H3LLP/Ergo-Split/README.md

# Ergo-Split
Ergonomic Split keyboard
A somewhat low-profile wireless 46-key keyboard that uses a dongle for connection.
Supports Choc V1 and V2 switches, is hotswappable, and uses a 3.7V 800mAh 802535 for each side. PCB is screwed into the case with 2 M2x6 screws and self-taps.

Dongle Case: https://www.printables.com/model/651428-seeed-xiao-ble-case-with-led-hole
(Not made by me)

Firmware is ZMK

AI Disclosure:
Used AI to help with part selection and parts of the firmware




The schematic for the PCB is the same for both sides
