H3LLP/Ergo-Split/BOM.csv

Part | Type | Quantity | Unit price (USD) | Line total (USD) | Link | Vendor | Funding | Notes | Designator | Footprint | Value
0805 SMD Resistor 2M Ohms | Part | 2 | 2.81 | 2.81 | https://www.aliexpress.us/item/3256806797741926.html |  | Grant |  | 2M1, 2M2 | 0805 | R3
0805 SMD Resistor 806K Ohms | Part | 2 | 2.27 | 2.27 | https://www.aliexpress.us/item/3256804997915352.html |  | Grant |  | 806K1, 806K2 | 0805 | R1
1N4148W T4 SOD-123 | Part | 46 | 3.60 | 3.60 | https://www.aliexpress.us/item/3256811977042224.html |  | Grant |  | D1, D10, D11, D12, D13, D14, D15, D16, D17, D18, D19, D2, D20, D21, D22, D23, D24, D25, D26, D27, D28, D29, D3, D30, D31, D32, D33, D34, D35, D36, D37, D38, D39, D4, D40, D41, D42, D43, D44, D45, D... | D_SOD-123 | D
Kalih Choc Low Profile Socket | Part | 46 | 7.37 | 7.37 | https://www.aliexpress.us/item/3256808357010978.html |  | Grant |  | SW1, SW10, SW11, SW12, SW13, SW14, SW15, SW16, SW17, SW18, SW19, SW2, SW20, SW21, SW22, SW23, SW24, SW25, SW26, SW27, SW28, SW29, SW3, SW30, SW31, SW32, SW33, SW34, SW35, SW36, SW37, SW38, SW39, SW... | SW_Hotswap_Kailh_Choc_V1V2_1.00u | ~
XIAO nRF52840 | Part | 3 | 32.08 | 32.08 | https://www.aliexpress.us/item/3256808047100037.html |  | Grant |  | U1, U2 | modified-XIAO-nRF52840-SMD | XIAO-nRF52840-SMD
Any Choc V1/V2 Switches | Part | 46 | 28.23 | 28.23 | https://www.aliexpress.us/item/3256808697103313.html |  | Grant |  | ~ | ~ | ~
3.7V 800mAh 802535 | Part | 2 | 5.99 | 5.99 | https://www.aliexpress.us/item/3256804695633953.html |  | Grant |  | ~ | ~ | ~
Left Case + Right Case | 3D printed | 2 | 17.06 | 17.06 |  |  | Paying myself | JLC3DP | ~ | ~ | ~
keycaps | 3D printed | 46 | 15.04 | 14.72 |  |  | Paying myself | JLC3DP | ~ | ~ | ~
PCB | PCB | 1 | 24.20 | 24.20 |  |  | Grant | JLCPCB | ~ | ~ | ~
M2*6 Screws | Part | 4 | 1.55 | 1.55 | https://www.aliexpress.us/item/2251832624557792.html |  | Already own |  | ~ | ~ | ~
Shipping | Shipping | 1 |  | 29.50 |  |  | Grant
Total |  |  |  | 169.38
Grant total |  |  |  | 136.05
