H3LLP/Ergo-Split/CAD/ErgoKeeb_Right.step

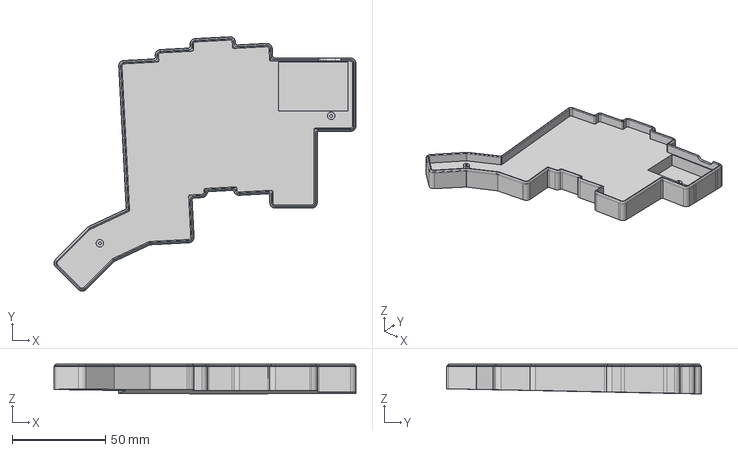
[picture p1: CAD file, 2026-11-11]
CAD/ErgoKeeb_Right.step
161.5 x 136.1 x 16.0 mm
