H3LLP/Ergo-Split/(list of files, cad)

Other CAD files:
CAD/ErgoKeeb_Left.step
CAD/ErgoKeeb.f3z
