H3LLP/Ergo-Split/PCB/ErgoKeeb.kicad_pcb

## KiCad design PCB/ErgoKeeb.kicad_pcb (2026-11-11)

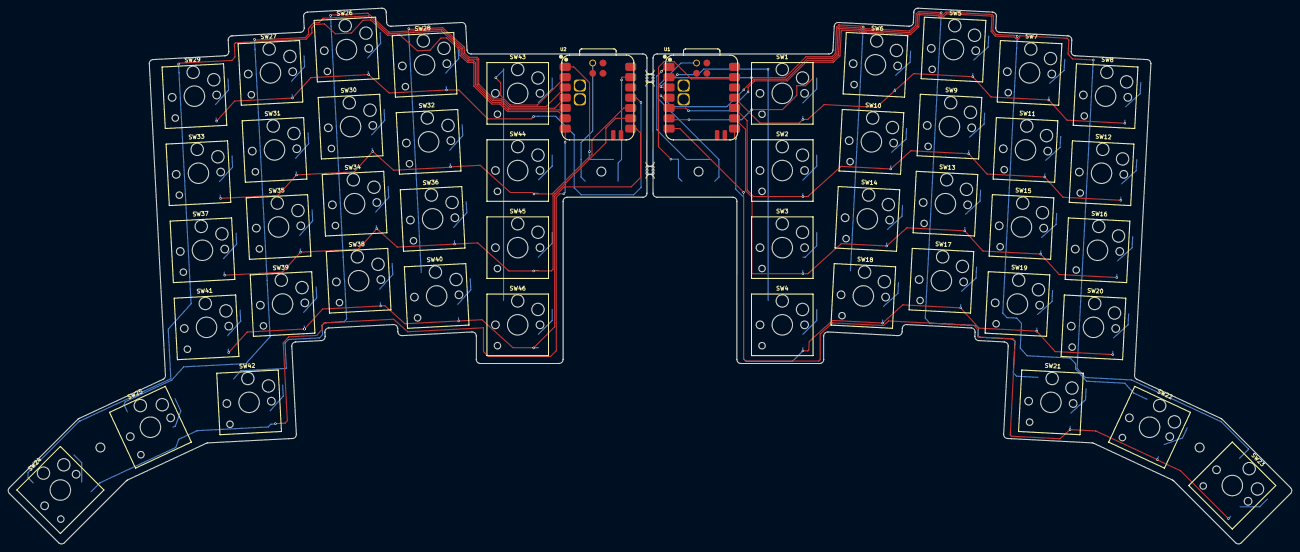
[picture p3: board ErgoKeeb.kicad_pcb from above]

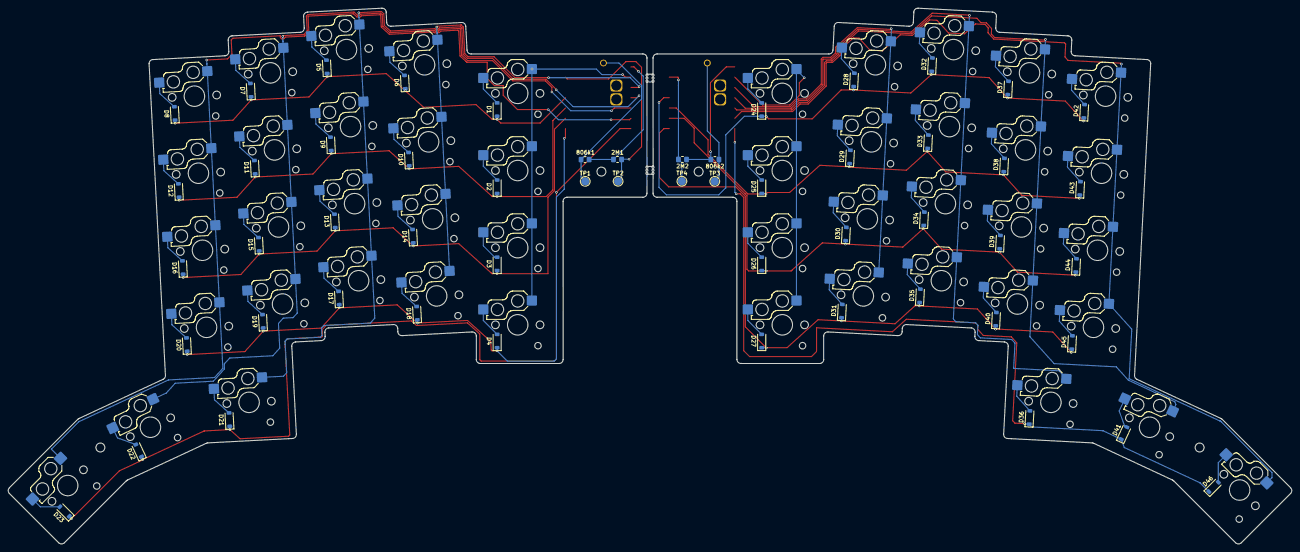
[picture p4: board ErgoKeeb.kicad_pcb from below]

Board: 2 copper layers, 316.9 x 132.3 mm, 108 parts (54 on the bottom side), 72 nets.

Parts:
2M1, 2M2: R3; R_0805_2012Metric_Pad1.20x1.40mm_HandSolder
806k1, 806k2: R1; R_0805_2012Metric_Pad1.20x1.40mm_HandSolder
BO1, BO2: MountingHole; mouse-bite-2mm-slot
D1, D2, D3, D4, D5, D6, D7, D8, D9, D10, D11, D12, D13, D14, D15, D16, D17, D18, D19, D20, D21, D22, D23, D24, D25, D26, D27, D28, D29, D30, D31, D32, D33, D34, D35, D36, D37, D38, D39, D40, D41, D42, D43, D44, D45, D46: D; D_SOD-123
H1, H2, H3, H4: MountingHole; MountingHole_2.2mm_M2
SW1, SW2, SW3, SW4, SW5, SW6, SW7, SW8, SW9, SW10, SW11, SW12, SW13, SW14, SW15, SW16, SW17, SW18, SW19, SW20, SW21, SW22, SW23, SW24, SW25, SW26, SW27, SW28, SW29, SW30, SW31, SW32, SW33, SW34, SW35, SW36, SW37, SW38, SW39, SW40, SW41, SW42, SW43, SW44, SW45, SW46: SW_Hotswap_Kailh_Choc_V1V2_1.00u
TP1, TP3: BAT; TestPoint_Pad_D2.0mm
TP2, TP4: GND; TestPoint_Pad_D2.0mm
U1, U2: XIAO-nRF52840-SMD; modified-XIAO-nRF52840-SMD

Connections:
/left/BT_PIN: 2M1.1, 806k1.2, U1.1 (D0)
/left/Ground: 2M1.2, TP2.1 (1_1), U1.13 (GND)
/left/VBAT: 806k1.1, TP1.1 (1_1), U1.19 (VBAT)
/left/col 0: SW1.1, SW2.1, SW3.1, SW4.1, U1.2 (D1)
/left/col 1: SW6.1, SW10.1, SW14.1, SW18.1, U1.3 (D2)
/left/col 2: SW5.1, SW9.1, SW13.1, SW17.1, SW21.1, U1.4 (D3)
/left/col 3: SW7.1, SW11.1, SW15.1, SW19.1, SW22.1, U1.5 (D4)
/left/col 4: SW8.1, SW12.1, SW16.1, SW20.1, SW23.1, U1.6 (D5)
/left/row 0: D1.1 (K), D5.1 (K), D6.1 (K), D7.1 (K), D8.1 (K), U1.11 (D10)
/left/row 1: D2.1 (K), D9.1 (K), D10.1 (K), D11.1 (K), D12.1 (K), U1.10 (D9)
/left/row 2: D3.1 (K), D13.1 (K), D14.1 (K), D15.1 (K), D16.1 (K), U1.9 (D8)
/left/row 3: D4.1 (K), D17.1 (K), D18.1 (K), D19.1 (K), D20.1 (K), U1.8 (D7)
/left/row 4: D21.1 (K), D22.1 (K), D23.1 (K), U1.7 (D6)
/right/BT_PIN: 2M2.1, 806k2.2, U2.1 (D0)
/right/Ground: 2M2.2, TP4.1 (1_1), U2.13 (GND)
/right/VBAT: 806k2.1, TP3.1 (1_1), U2.19 (VBAT)
/right/col 0: SW43.1, SW44.1, SW45.1, SW46.1, U2.2 (D1)
/right/col 1: SW28.1, SW32.1, SW36.1, SW40.1, U2.3 (D2)
/right/col 2: SW26.1, SW30.1, SW34.1, SW38.1, SW42.1, U2.4 (D3)
/right/col 3: SW25.1, SW27.1, SW31.1, SW35.1, SW39.1, U2.5 (D4)
/right/col 4: SW24.1, SW29.1, SW33.1, SW37.1, SW41.1, U2.6 (D5)
/right/row 0: D24.1 (K), D28.1 (K), D32.1 (K), D37.1 (K), D42.1 (K), U2.11 (D10)
/right/row 1: D25.1 (K), D29.1 (K), D33.1 (K), D38.1 (K), D43.1 (K), U2.10 (D9)
/right/row 2: D26.1 (K), D30.1 (K), D34.1 (K), D39.1 (K), D44.1 (K), U2.9 (D8)
/right/row 3: D27.1 (K), D31.1 (K), D35.1 (K), D40.1 (K), D45.1 (K), U2.8 (D7)
/right/row 4: D36.1 (K), D41.1 (K), D46.1 (K), U2.7 (D6)
unnamed: D1.2 (A), SW1.2
unnamed: D2.2 (A), SW2.2
unnamed: D3.2 (A), SW3.2
unnamed: D4.2 (A), SW4.2
unnamed: D5.2 (A), SW5.2
unnamed: D6.2 (A), SW6.2
unnamed: D7.2 (A), SW7.2
unnamed: D8.2 (A), SW8.2
unnamed: D9.2 (A), SW9.2
unnamed: D10.2 (A), SW10.2
unnamed: D11.2 (A), SW11.2
unnamed: D12.2 (A), SW12.2
unnamed: D13.2 (A), SW13.2
unnamed: D14.2 (A), SW14.2
unnamed: D15.2 (A), SW15.2
unnamed: D16.2 (A), SW16.2
unnamed: D17.2 (A), SW17.2
unnamed: D18.2 (A), SW18.2
unnamed: D19.2 (A), SW19.2
unnamed: D20.2 (A), SW20.2
unnamed: D21.2 (A), SW21.2
unnamed: D22.2 (A), SW22.2
unnamed: D23.2 (A), SW23.2
unnamed: D24.2 (A), SW43.2
unnamed: D25.2 (A), SW44.2
unnamed: D26.2 (A), SW45.2
unnamed: D27.2 (A), SW46.2
unnamed: D28.2 (A), SW28.2
unnamed: D29.2 (A), SW32.2
unnamed: D30.2 (A), SW36.2
unnamed: D31.2 (A), SW40.2
unnamed: D32.2 (A), SW26.2
unnamed: D33.2 (A), SW30.2
unnamed: D34.2 (A), SW34.2
unnamed: D35.2 (A), SW38.2
unnamed: D36.2 (A), SW42.2
unnamed: D37.2 (A), SW27.2
unnamed: D38.2 (A), SW31.2
unnamed: D39.2 (A), SW35.2
unnamed: D40.2 (A), SW39.2
unnamed: D41.2 (A), SW25.2
unnamed: D42.2 (A), SW29.2
unnamed: D43.2 (A), SW33.2
unnamed: D44.2 (A), SW37.2
unnamed: D45.2 (A), SW41.2
unnamed: D46.2 (A), SW24.2
