H3LLP/Ergo-Split/(commit log)

2026-11-11 Revise BOM structure and add product details
    Updated BOM with additional columns for Part Name, Price, and Link, and removed old entries.
    [bom.csv]
2026-11-11 Revise BOM entries and formatting
    Updated the BOM file to include new parts and corrected formatting.
    [bom.csv]
2026-11-11 Revise bom.csv with new parts and formatting fixes
    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
    [bom.csv]
2026-11-11 Fix BOM CSV formatting and add missing header
    [bom.csv]
2026-11-11 Fix BOM CSV formatting and remove duplicate header
    Removed duplicate header and adjusted entries.
    [bom.csv]
2026-11-11 Update BOM with new components and quantities
    Added new components including screws and updated quantities.
    [bom.csv]
2026-11-11 Update BOM with new part details and prices
    Restored the header row and updated part details with new prices and links.
    [bom.csv]
2026-11-11 Revise bom.csv with new components and formatting
    Updated BOM file to include new parts and corrected formatting.
    [bom.csv]
2026-11-11 Adjust shipping and total amounts in BOM.csv
    Updated shipping and total costs in BOM.csv.
    [BOM.csv]
2026-11-11 Change keycaps from Part to 3D printed
    [BOM.csv]
2026-11-11 Correct screw size for PCB in README
    Updated the screw specification for the PCB in the README.
2026-11-11 Update README with dongle case link and AI disclosure
    Added AI disclosure and dongle case link to README.
2026-11-11 Update BOM.csv with revised shipping and totals
    [BOM.csv]
